tilman1/CodeCracker/Schematic/SafePuzzle.pdf

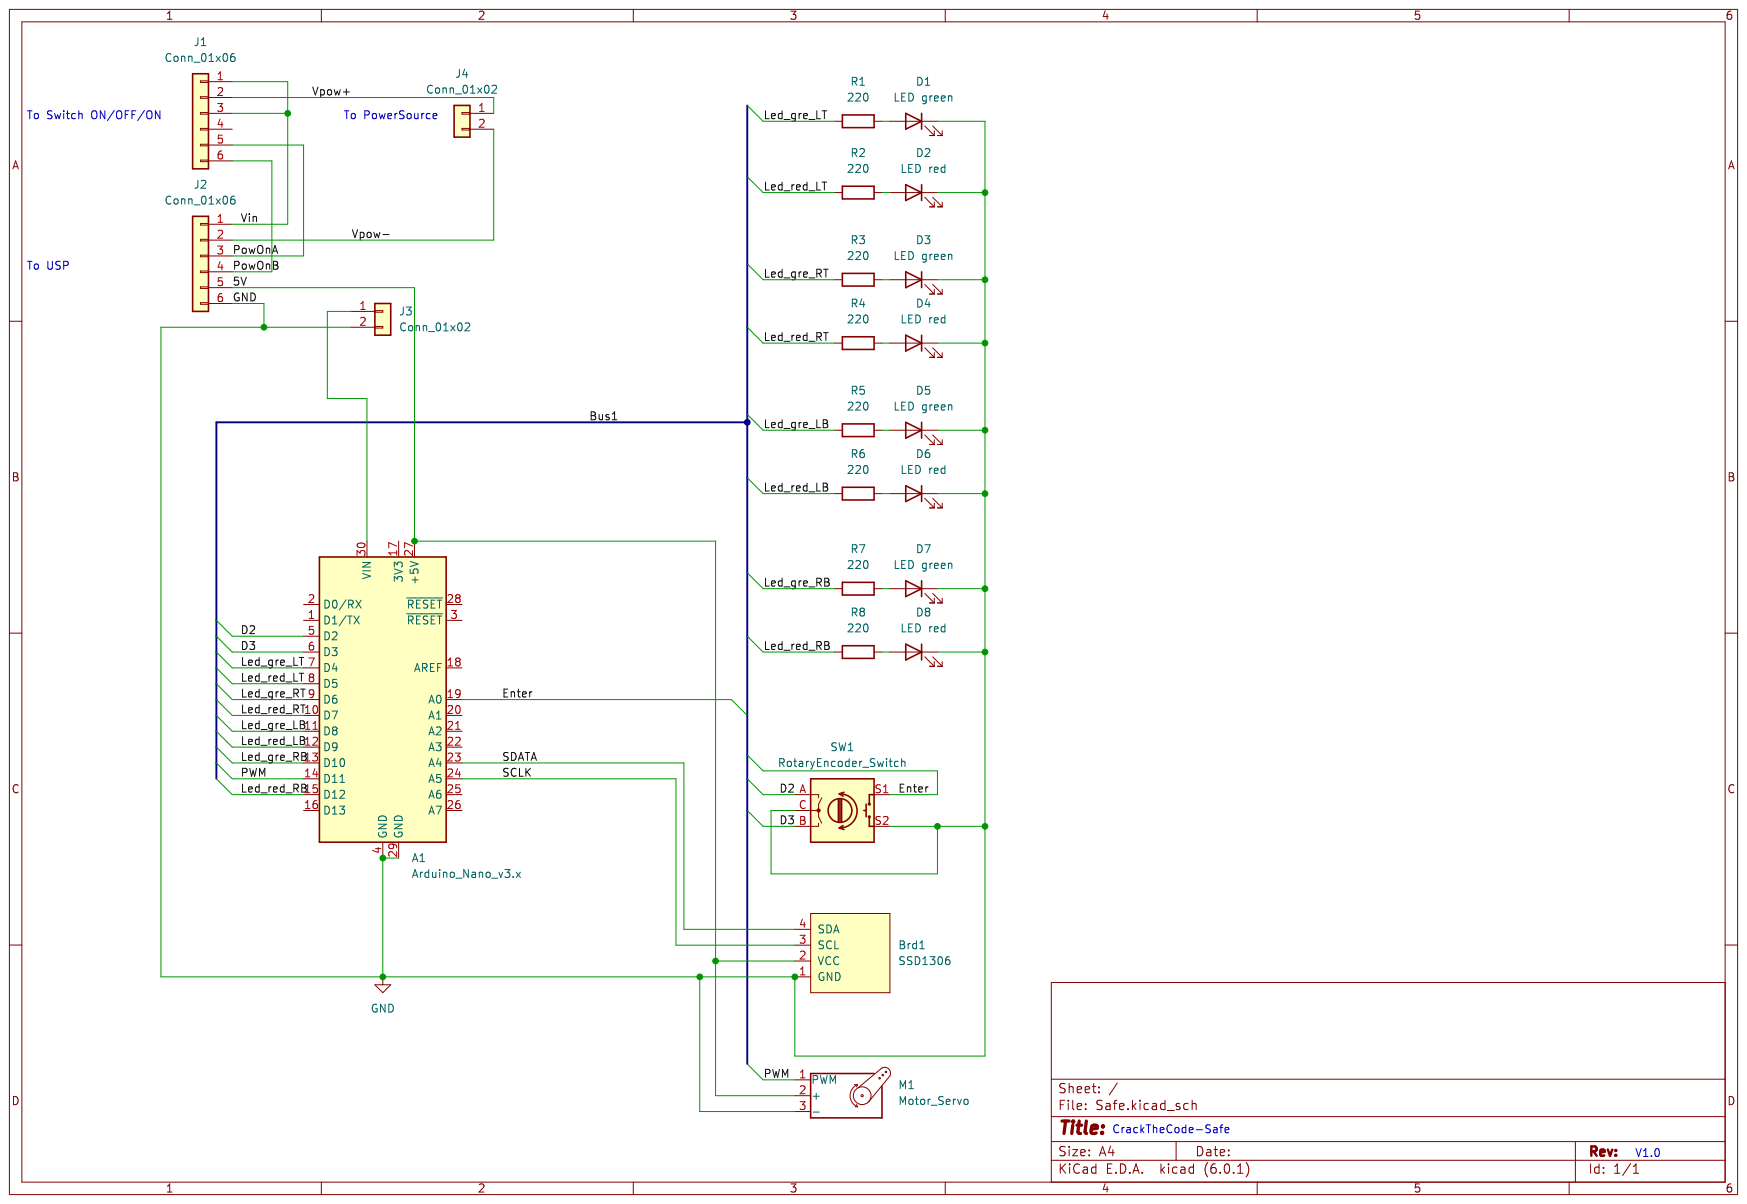
[picture p27: page 1]
