tilman1/CodeCracker/(commit log)

2023-06-28 Initial commit - schematic for the crack-the-code-puzzle - completely rewritten software. The original software was written by Michael Klements
    Changes to be committed:
    new file: SafePuzzle2/SafePuzzle2.ino
    new file: Schematic/SafePuzzle.pdf
    [SafePuzzle2.ino]
2023-06-29 - Assembly Manual in German added - Bug Fix: LED notifier show one red LED too many if combination consisted of identical digits (entering 1011 with a combination of 1111 would show 4 red lights)
    new file: AssemblyInstructions/BauanleitungCrackTheCodeV1.0.pdf
    modified: SafePuzzle2/SafePuzzle2.ino
    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
    [SafePuzzle2.ino]
2026-04-18 Bugfix: Refresh only after _encoder is assigned
    [SafePuzzle2.ino]
2026-04-18 Add support for ESP32
2026-04-20 Add warning to disconnect the battery during flashing on page 21
    modified: BauanleitungCrackTheCodeV1.0.pdf
    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
